syntaxguild/tacpad-9/docs/tacpad9-design.md

# Tacpad 9 design sources

The current model, manufacturing interfaces and render commands are documented in [printing & assembly](assembly.md). Product dimensions and wiring are in [hardware.md](hardware.md); proof and limitations are in [validation.md](validation.md).

- [Parametric model](../mechanical/model.py)
- [Reference hardware dimensions](../mechanical/reference.json)
- [Product studio](../mechanical/render.py)
- [Service / exploded photography](../mechanical/service.py)
- [Original Primadon mascot](assets/primadon-logo.png)
- [Square render](assets/tacpad9-square.png) / [16:9 render](assets/tacpad9-wide.png)
- [Versioned Blender and mesh downloads](https://github.com/syntaxguild/tacpad-9/releases/tag/v0.3.0)

The original root-level scripts and superseded binary exports were reorganized for v0.3.0. Their earlier versions remain available in Git history.
