syntaxguild/tacpad-9/renders/primadon/exports/Tacpad 9.stl

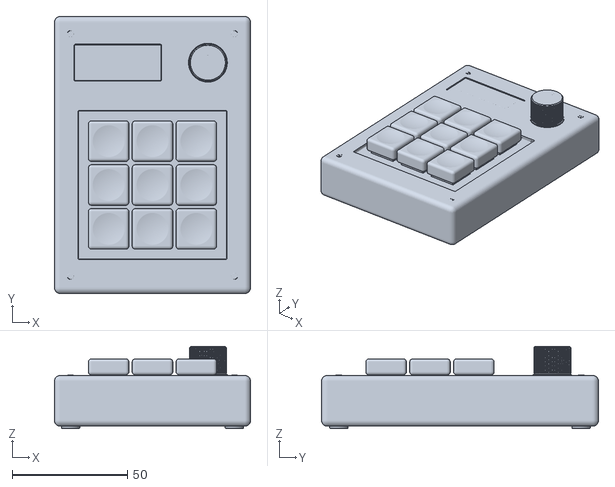
[picture p7: CAD file, 2026-10-17, last stored version]
renders/primadon/exports/Tacpad 9.stl
85.0 x 120.0 x 35.5
