syntaxguild/tacpad-9/(list of files, cad)

Other CAD files:
renders/primadon/Tacpad_9_Primadon.blend
renders/primadon/exports/Tacpad 9.obj
