syntaxguild/tacpad-9/(commit log)

2026-10-17 feat: add Primadon TacPad-9 firmware and Wokwi circuit
2026-10-17 fix: initialize OLED directly and fit UI to 128x32
    [main.cpp, oled_smoke_test.cpp]
2026-10-17 fix: render a working wide OLED in Wokwi
    [primadon-oled.chip.c]
2026-10-17 feat: add parametric Tacpad enclosure
2026-10-17 feat: add Primadon branding and final renders
    [Tacpad 9.obj, Tacpad 9.stl, Tacpad_9_Primadon.blend]
2026-10-17 feat: add ESP32-S3 USB keyboard and media HID
2026-10-17 feat: add service mounts and printable interfaces
2026-10-17 chore: organize portfolio and release workflow
    [Tacpad 9.obj, Tacpad 9.stl, Tacpad_9_Primadon.blend]
2026-10-17 refactor: centralize macro bindings
    [hid_output.h, keymap.h, main.cpp]
2026-10-17 docs: add design case study for v0.3.0
